nzin/hifi-bananapro/alarmclock6.brd

## EAGLE design alarmclock6.brd (2017-12-25)

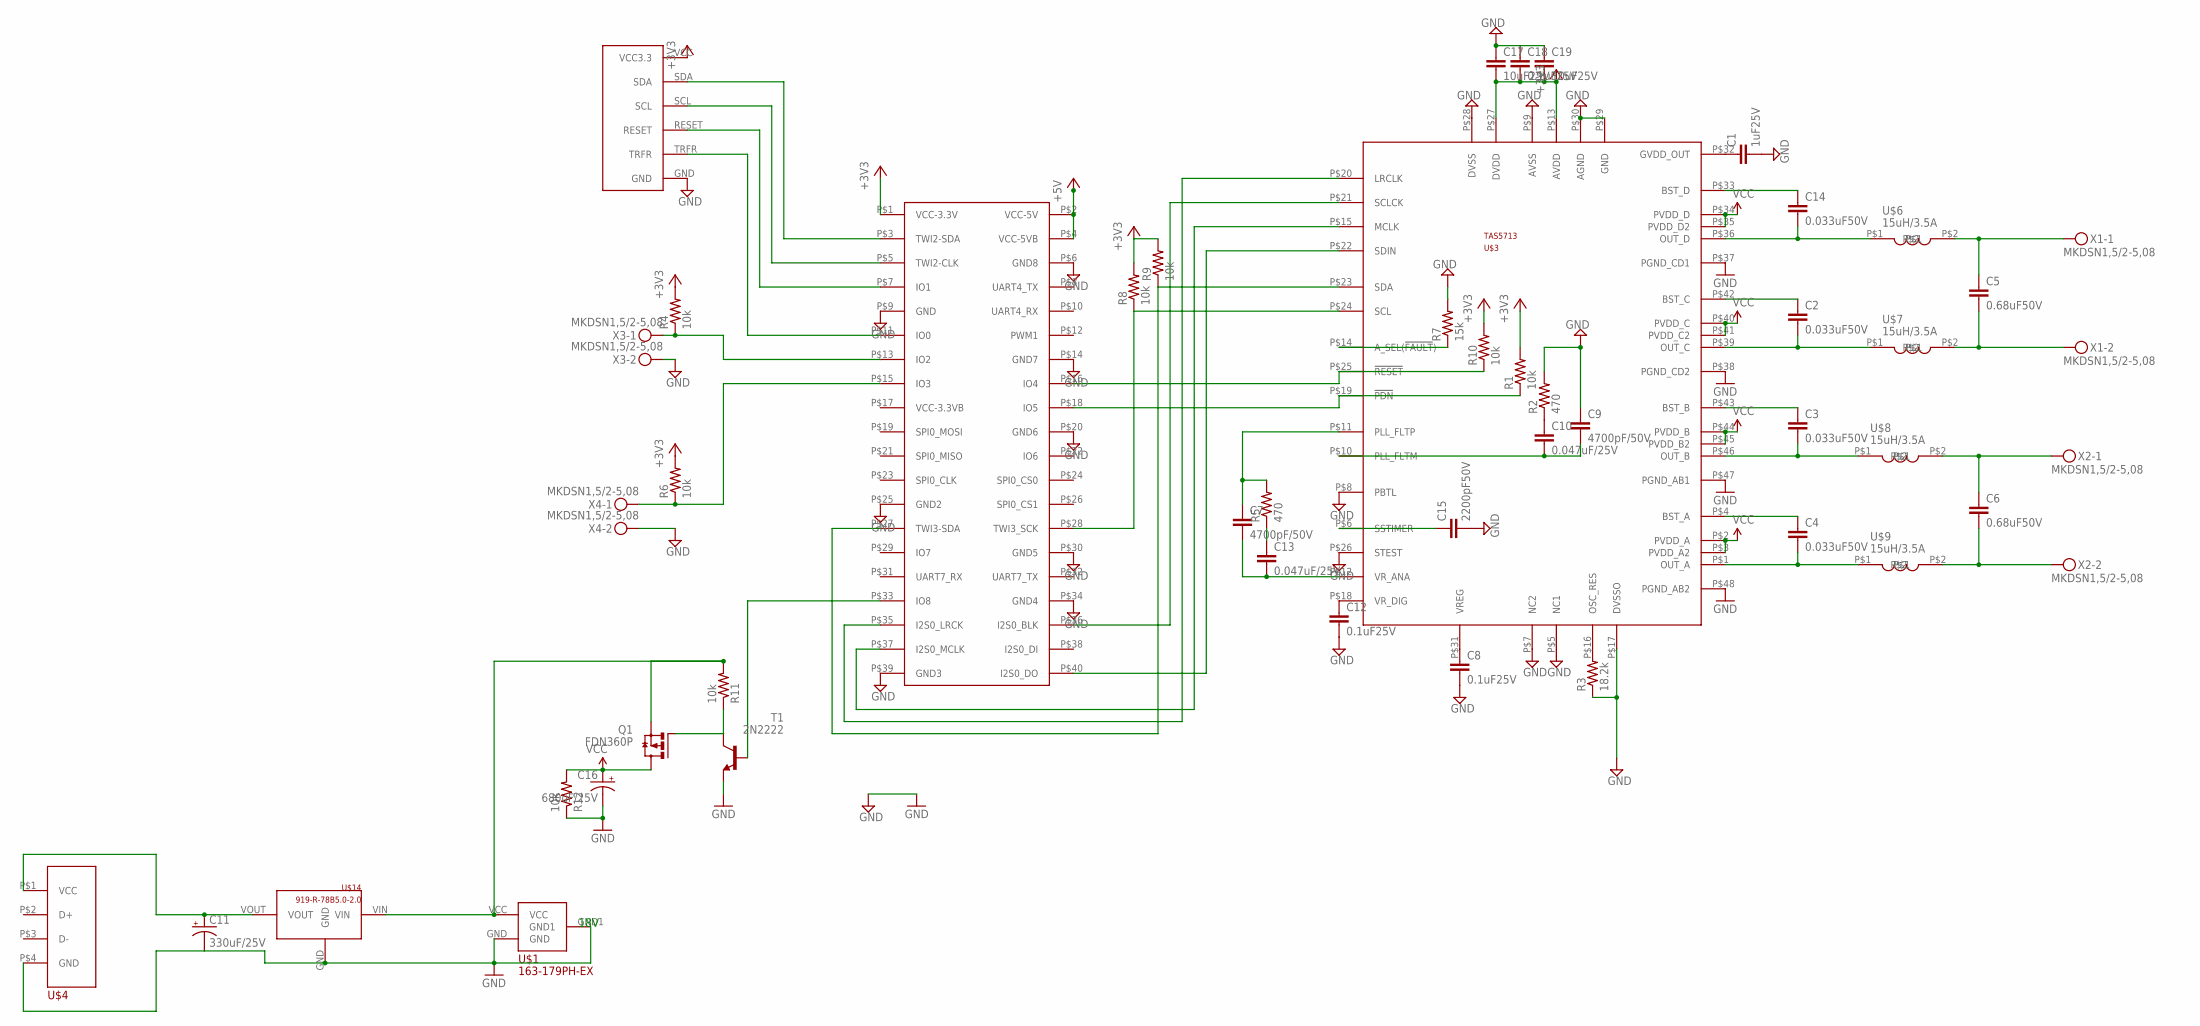
[picture p1: schematic alarmclock6.sch]

Parts:
C1: 1uF25V; 0603-CAP
C2, C3, C4, C14: 0.033uF50V; 0603-CAP
C5, C6: 0.68uF50V; 0603-CAP
C7, C9: 4700pF/50V; 0603-CAP
C8, C12, C18: 0.1uF25V; 0603-CAP
C10, C13: 0.047uF/25V; 0603-CAP
C11: 330uF/25V; CPOL-RADIAL-10UF-25V
C15: 2200pF50V; 0603-CAP
C16: 680uF/25V; CPOL-RADIAL-10UF-25V
C17, C19: 10uF25V; 0603-CAP
Q1: FDN360P; SUPER-SOT3
R1, R4, R6, R8, R9, R10, R11, R12: 10k; 0603-RES
R2, R5: 470; 0603-RES
R3: 18.2k; 0603-RES
R7: 15k; 0603-RES
T1: 2N2222; TO18
U$1: 163-179PH-EX; 163-179PH-EX_DIM
U$3: TAS5713; TAS5713_DIM
U$4: USB_TYPEA_CONNECTOR; USB_DIM
U$5: BANANAPRO-CON6; BANANAPRO-CON6_DIM
U$6, U$7, U$8, U$9: 15uH/3.5A; MSS1260_DIM
U$10: SKYWRITER; SKYWRITER_DIM
U$14: 919-R-78B5.0-2.0; 919-R-78B5.0-2.0_DIM
X1, X2, X3, X4: MKDSN1,5/2-5,08

Connections:
+3V3: C17.2, C18.2, C19.2, R1.2, R4.2, R6.2, R8.2, R9.2, R10.2, U$3.P$13 (AVDD), U$3.P$27 (DVDD), U$5.P$1 (VCC-3.3V), U$10.VCC (VCC3.3)
+5V: U$5.P$2 (VCC-5V), U$5.P$4 (VCC-5VB)
GND: C1.2, C8.2, C9.1, C11.2 (-), C12.2, C15.2, C16.2 (-), C17.1, C18.1, C19.1, R2.2, R3.1, R7.2, R12.1, T1.1 (E), U$1.GND, U$1.GND1, U$3.P$5 (NC1), U$3.P$7 (NC2), U$3.P$8 (PBTL), U$3.P$9 (AVSS), U$3.P$17 (DVSSO), U$3.P$26 (STEST), U$3.P$28 (DVSS), U$3.P$29 (GND), U$3.P$30 (AGND), U$3.P$37 (PGND_CD1), U$3.P$38 (PGND_CD2), U$3.P$47 (PGND_AB1), U$3.P$48 (PGND_AB2), U$4.P$4 (GND), U$5.P$6 (GND8), U$5.P$9 (GND), U$5.P$14 (GND7), U$5.P$20 (GND6), U$5.P$25 (GND2), U$5.P$30 (GND5), U$5.P$34 (GND4), U$5.P$39 (GND3), U$10.GND, U$14.GND, X3.2, X4.2
unnamed: U$3.P$22 (SDIN), U$5.P$40 (I2S0_DO)
unnamed: U$3.P$15 (MCLK), U$5.P$37 (I2S0_MCLK)
unnamed: C11.1 (+), U$4.P$1 (VCC), U$14.VOUT
unnamed: U$3.P$20 (LRCLK), U$5.P$35 (I2S0_LRCK)
unnamed: U$3.P$21 (SCLCK), U$5.P$36 (I2S0_BLK)
unnamed: R6.1, U$5.P$15 (IO3), X4.1
unnamed: R3.2, U$3.P$16 (OSC_RES)
unnamed: R4.1, U$5.P$13 (IO2), X3.1
unnamed: C6.1, U$8.P$2, X2.1
unnamed: C14.2, U$3.P$36 (OUT_D), U$6.P$1
unnamed: C14.1, U$3.P$33 (BST_D)
unnamed: C4.1, U$3.P$4 (BST_A)
unnamed: C4.2, U$3.P$1 (OUT_A), U$9.P$1
unnamed: C3.2, U$3.P$46 (OUT_B), U$8.P$1
unnamed: C3.1, U$3.P$43 (BST_B)
unnamed: C2.2, U$3.P$39 (OUT_C), U$7.P$1
unnamed: C2.1, U$3.P$42 (BST_C)
unnamed: C6.2, U$9.P$2, X2.2
unnamed: C5.2, U$7.P$2, X1.2
unnamed: C5.1, U$6.P$2, X1.1
unnamed: C7.1, R5.2, U$3.P$11 (PLL_FLTP)
unnamed: C7.2, C13.2, U$3.P$12 (VR_ANA)
unnamed: C9.2, C10.2, U$3.P$10 (PLL_FLTM)
unnamed: C13.1, R5.1
unnamed: C10.1, R2.1
unnamed: C8.1, U$3.P$31 (VREG)
unnamed: C12.1, U$3.P$18 (VR_DIG)
unnamed: R1.1, U$3.P$19 (!PDN!), U$5.P$18 (IO5)
unnamed: U$5.P$3 (TWI2-SDA), U$10.SDA
unnamed: U$5.P$5 (TWI2-CLK), U$10.SCL
unnamed: U$5.P$7 (IO1), U$10.RESET
unnamed: U$5.P$11 (IO0), U$10.TRFR
unnamed: R7.1, U$3.P$14 (A_SEL(!FAULT!))
unnamed: R9.1, U$3.P$23 (SDA), U$5.P$27 (TWI3-SDA)
unnamed: R8.1, U$3.P$24 (SCL), U$5.P$28 (TWI3_SCK)
unnamed: R10.1, U$3.P$25 (!RESET!), U$5.P$16 (IO4)
unnamed: C1.1, U$3.P$32 (GVDD_OUT)
unnamed: C15.1, U$3.P$6 (SSTIMER)
unnamed: T1.2 (B), U$5.P$33 (IO8)
unnamed: Q1.1 (G), R11.1, T1.3 (C)
unnamed: Q1.2 (S), R11.2, U$1.VCC, U$14.VIN
VCC: C16.1 (+), Q1.3 (D), R12.2, U$3.P$2 (PVDD_A), U$3.P$3 (PVDD_A2), U$3.P$34 (PVDD_D), U$3.P$35 (PVDD_D2), U$3.P$40 (PVDD_C), U$3.P$41 (PVDD_C2), U$3.P$44 (PVDD_B), U$3.P$45 (PVDD_B2)

Notes on the sheet:
18V

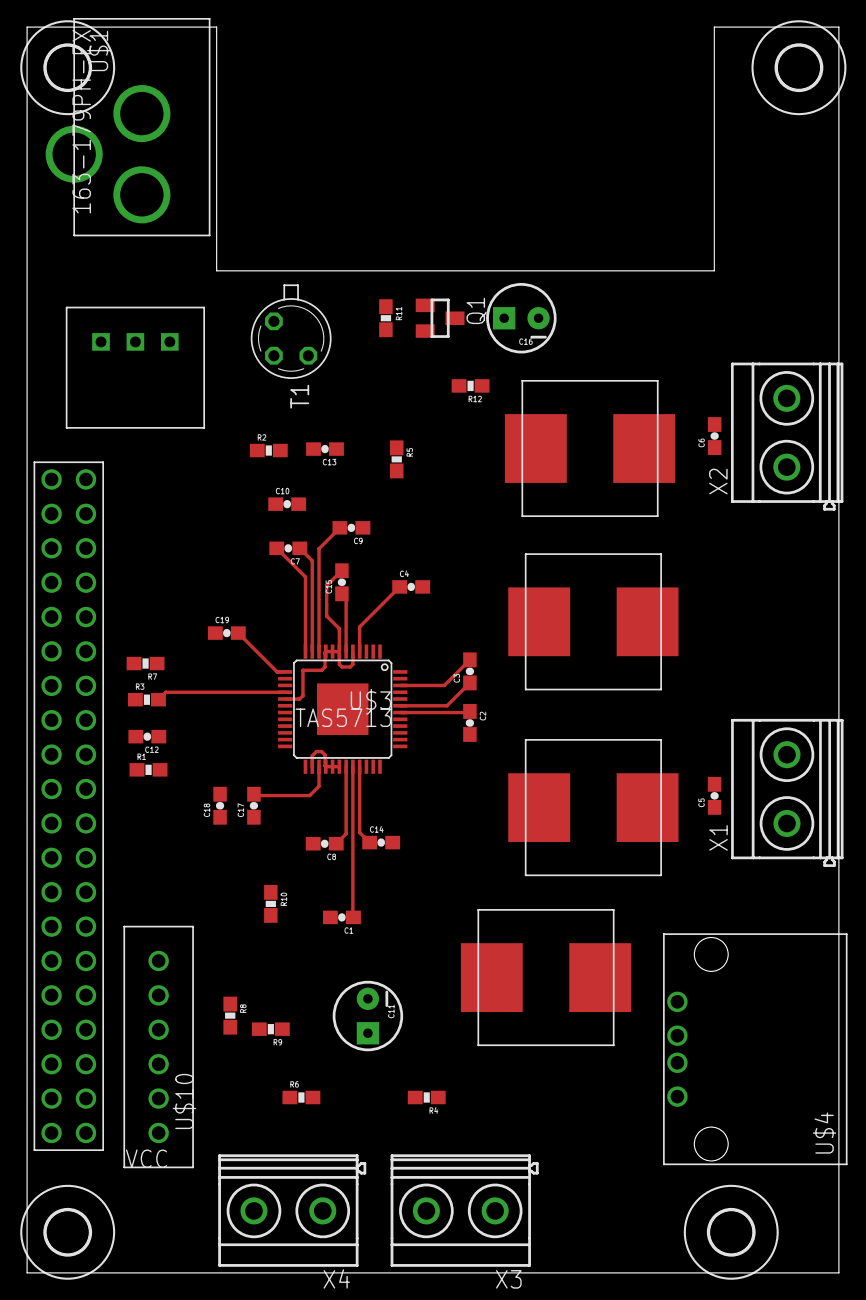
[picture p2: board alarmclock6.brd from above]

Board: 2 copper layers, 60.0 x 92.0 mm, 51 parts (0 on the bottom side), 45 nets.

Other parts of the board:
U$11, U$12, U$13, U$15: 3,2
