nzin/hifi-bananapro/(commit log)

2016-09-17 route 100%
    [alarmclock.sch, alarmclock3.brd]
2016-09-17 !00% routable
    [alarmclock3.brd]
2016-09-17 - separate gnd from 18v stage and 3.3v stage - add 2 gpio as terminal block (2 external push button) - complete the bom
    [alarmclock3.brd, alarmclock3.sch]
2016-09-17 -add the 10k smd for the push button
2016-09-17 put the 40 pin headers in the correct direction
    [alarmclock3.brd]
2016-09-17 alarmclock.sch is too old
    [alarmclock.sch]
2016-09-17 Revert "alarmclock.sch is too old"
    This reverts commit 8a25966ad4365e2754a0be729f3aaea1cfe3d248.
    [alarmclock.sch]
2016-09-18 add extension to the skywriter (https://www.modmypi.com/raspberry-pi/breakout-boards/pimoroni/pimoroni-skywriter)
    [alarmclock3.brd, alarmclock3.sch]
2016-10-07 new board
    [alarmclock3.brd, alarmclock4.brd, alarmclock4.sch]
2016-10-30 - 2 bugfix: orientation of dc-dc + TAS pin SEL must not be to ground - remove via under the TAS chip
    [alarmclock4.brd, alarmclock4.sch]
2016-10-30 move the capa
    [alarmclock4.brd]
2016-12-23 new schema with i2c with pullup
    [alarmclock5.brd, alarmclock5.sch]
2016-12-23 fully routed
    [alarmclock5.brd]
2016-12-23 add a reset pin
    [alarmclock5.brd, alarmclock5.sch]
2017-01-13 bugfix: !reset! not connect directly to vcc
    [alarmclock5.brd]
2017-01-14 new board with RESET and PDN accessible via GPIO
    [alarmclock5.brd, alarmclock5.sch]
2017-03-04 new schema
    [alarmclock5.brd, alarmclock5.sch]
2017-03-04 add a R10k resistor to flush the capa
    [alarmclock5.brd, alarmclock5.sch]
2017-03-04 update bom
2017-10-13 update especially mouser.lbr
    [alarmclock5.brd, alarmclock5.sch]
2017-10-29 new decoupling capa
    [alarmclock5.brd, alarmclock5.sch]
2017-12-25 replace the DC-DC converter to a 2A (instead of 400mA)
    [alarmclock6.brd, alarmclock6.sch]
2017-12-25 bugfix on DC-DC converter
    [alarmclock6.brd, alarmclock6.sch]
